Jo-yongju/ethernet-rs422-gateway/tests/테스트방법.md

Protocol V1 / Remote Node Unit Test

Folder structure

ethernet_rs422_gateway_protocol/
├─ common/
│  ├─ crc16.h
│  ├─ crc16.c
│  ├─ protocol.h
│  ├─ protocol.c
│  ├─ stream_parser.h
│  └─ stream_parser.c
├─ tests/
│  ├─ protocol_test.c
│  └─ stream_parser_test.c
└─ firmware/f429_remote_node/
   ├─ App/
   ├─ Common/
   └─ Tests/remote_node_test.c

Windows / MinGW GCC

From the project root:

gcc common\crc16.c common\protocol.c tests\protocol_test.c -Icommon -std=c11 -Wall -Wextra -Wpedantic -o protocol_test.exe
.\protocol_test.exe

gcc common\crc16.c common\protocol.c common\stream_parser.c tests\stream_parser_test.c -Icommon -std=c11 -Wall -Wextra -Wpedantic -o stream_parser_test.exe
.\stream_parser_test.exe

gcc firmware\f429_remote_node\Common\crc16.c firmware\f429_remote_node\Common\protocol.c firmware\f429_remote_node\Common\stream_parser.c firmware\f429_remote_node\App\Src\remote_node.c firmware\f429_remote_node\App\Src\uart_rx_ring.c firmware\f429_remote_node\Tests\remote_node_test.c -Ifirmware\f429_remote_node\Common -Ifirmware\f429_remote_node\App\Inc -std=c11 -Wall -Wextra -Wpedantic -o remote_node_test.exe
.\remote_node_test.exe

WSL / Linux GCC

gcc common/crc16.c common/protocol.c tests/protocol_test.c \
  -Icommon -std=c11 -Wall -Wextra -Wpedantic \
  -o protocol_test

./protocol_test

gcc common/crc16.c common/protocol.c common/stream_parser.c tests/stream_parser_test.c \
  -Icommon -std=c11 -Wall -Wextra -Wpedantic \
  -o stream_parser_test

./stream_parser_test

gcc firmware/f429_remote_node/Common/crc16.c \
  firmware/f429_remote_node/Common/protocol.c \
  firmware/f429_remote_node/Common/stream_parser.c \
  firmware/f429_remote_node/App/Src/remote_node.c \
  firmware/f429_remote_node/App/Src/uart_rx_ring.c \
  firmware/f429_remote_node/Tests/remote_node_test.c \
  -Ifirmware/f429_remote_node/Common \
  -Ifirmware/f429_remote_node/App/Inc \
  -std=c11 -Wall -Wextra -Wpedantic \
  -o remote_node_test

./remote_node_test

Expected result:

Protocol: 9 passed, 0 failed
Stream Parser: 8 passed, 0 failed
Remote Node: 13 passed, 0 failed
Total: 30 passed, 0 failed

Later in STM32CubeIDE

The reusable files are:

crc16.h
crc16.c
protocol.h
protocol.c
stream_parser.h
stream_parser.c

The files under tests/ and firmware/f429_remote_node/Tests/ are only for PC-side unit tests.

Do not put HAL calls inside the reusable protocol modules.
HAL/UART/SPI/Ethernet code will call these modules from the STM32 application layer.
