Jo-yongju/ethernet-rs422-gateway/results/day10/tcp_rtt_20000_1ms.csv

seq | rtt_ms | status
1 | 3.877100 | OK
2 | 4.412800 | OK
3 | 4.012900 | OK
4 | 4.248000 | OK
5 | 4.366900 | OK
6 | 4.008300 | OK
7 | 3.910300 | OK
8 | 4.675800 | OK
9 | 4.656300 | OK
10 | 4.949200 | OK
11 | 4.296000 | OK
12 | 4.325600 | OK
13 | 4.512600 | OK
14 | 4.680800 | OK
15 | 4.408100 | OK
16 | 5.667400 | OK
17 | 4.586800 | OK
18 | 4.884100 | OK
19 | 4.713700 | OK
20 | 4.675900 | OK
21 | 4.700800 | OK
22 | 4.473300 | OK
23 | 4.676500 | OK
24 | 4.855000 | OK
25 | 4.873700 | OK
26 | 4.847500 | OK
27 | 4.913600 | OK
28 | 4.078600 | OK
29 | 4.888100 | OK
30 | 4.906600 | OK
31 | 4.982600 | OK
32 | 4.757000 | OK
33 | 4.497900 | OK
34 | 4.052300 | OK
35 | 5.812200 | OK
36 | 4.570400 | OK
37 | 4.691700 | OK
38 | 4.837900 | OK
39 | 4.196400 | OK
40 | 4.708900 | OK
41 | 4.631200 | OK
42 | 4.763900 | OK
43 | 4.895100 | OK
44 | 5.554300 | OK
45 | 4.965600 | OK
46 | 4.465400 | OK
47 | 4.410500 | OK
48 | 4.646500 | OK
49 | 5.247800 | OK
50 | 4.996400 | OK
51 | 4.695100 | OK
52 | 4.723000 | OK
53 | 4.950500 | OK
54 | 4.771800 | OK
55 | 6.698400 | OK
56 | 4.682600 | OK
57 | 4.597200 | OK
58 | 4.878400 | OK
59 | 4.690400 | OK
60 | 5.025000 | OK
61 | 5.076200 | OK
62 | 4.665900 | OK
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
