Jo-yongju/ethernet-rs422-gateway/firmware/f429_remote_node/f429_remote_node.ioc

Mcu.UserName=STM32F429ZITx
PA0/WKUP.GPIO_Label=B1 [Blue PushButton]
PA0/WKUP.Signal=GPXTI0
PA1.GPIO_Label=MEMS_INT1 [L3GD20_INT1]
PA1.Signal=GPXTI1
PA10.GPIO_Label=STLINK_TX [STM32F103CBT6_PA2]
PA10.Signal=USART1_RX
PA11.GPIO_Label=R4
PA11.Signal=LTDC_R4
PA12.GPIO_Label=R5
PA12.Signal=LTDC_R5
PA13.GPIO_Label=SWDIO
PA13.Signal=SYS_JTMS-SWDIO
PA14.GPIO_Label=SWCLK
PA14.Signal=SYS_JTCK-SWCLK
PA15.GPIO_Label=TP_INT1 [Touch Panel]
PA15.Signal=GPXTI15
PA2.GPIO_Label=MEMS_INT2 [L3GD20_INT2]
PA2.Signal=GPXTI2
PA3.GPIO_Label=B5
PA3.Signal=LTDC_B5
PA4.GPIO_Label=VSYNC
PA4.Signal=LTDC_VSYNC
PA6.GPIO_Label=G2
PA6.Signal=LTDC_G2
PA7.GPIO_Label=ACP_RST
PA7.Signal=GPIO_Output
PA8.GPIO_Label=I2C3_SCL [ACP/RF_SCL]
PA8.Signal=I2C3_SCL
PA9.GPIO_Label=STLINK_RX [STM32F103CBT6_PA3]
PA9.Signal=USART1_TX
PB0.GPIO_Label=R3
PB0.Signal=LTDC_R3
PB1.GPIO_Label=R6
PB1.Signal=LTDC_R6
PB10.GPIO_Label=G4
PB10.Signal=LTDC_G4
PB11.GPIO_Label=G5
PB11.Signal=LTDC_G5
PB12.GPIO_Label=OTG_HS_ID
PB12.Signal=USB_OTG_HS_ID
PB13.GPIO_Label=VBUS_HS
PB13.Signal=USB_OTG_HS_VBUS
PB14.GPIO_Label=OTG_HS_DM
PB14.Signal=USB_OTG_HS_DM
PB15.GPIO_Label=OTG_HS_DP
PB15.Signal=USB_OTG_HS_DP
PB2/BOOT1.GPIO_Label=BOOT1
PB2/BOOT1.Signal=GPIO_Input
PB5.GPIO_Label=SDCKE1
PB5.Signal=FMC_SDCKE1
PB6.GPIO_Label=SDNE1 [SDRAM_CS]
PB6.Signal=FMC_SDNE1
PB8.GPIO_Label=B6
PB8.Signal=LTDC_B6
PB9.GPIO_Label=B7
PB9.Signal=LTDC_B7
PC0.GPIO_Label=SDNWE
PC0.Signal=FMC_SDNWE
PC1.GPIO_Label=NCS_MEMS_SPI [L3GD20_CS_I2C/SPI]
PC1.Signal=GPIO_Output
PC10.GPIO_Label=R2
PC10.Signal=LTDC_R2
PC12.Signal=UART5_TX
PC14/OSC32_IN.GPIO_Label=PC14-OSC32_IN
PC14/OSC32_IN.Signal=RCC_OSC32_IN
PC15/OSC32_OUT.GPIO_Label=PC15-OSC32_OUT
PC15/OSC32_OUT.Signal=RCC_OSC32_OUT
PC2.GPIO_Label=CSX [LCD-RGB_CSX]
PC2.Signal=GPIO_Output
PC4.GPIO_Label=OTG_FS_PSO [OTG_FS_PowerSwitchOn]
PC4.Signal=GPIO_Output
PC5.GPIO_Label=OTG_FS_OC [OTG_FS_OverCurrent]
PC5.Signal=GPXTI5
PC6.GPIO_Label=HSYNC
PC6.Signal=LTDC_HSYNC
PC7.GPIO_Label=G6
PC7.Signal=LTDC_G6
PC9.GPIO_Label=I2C3_SDA [ACP/RF_SDA]
PC9.Signal=I2C3_SDA
PD0.GPIO_Label=D2
PD0.Signal=FMC_D2_DA2
PD1.GPIO_Label=D3
PD1.Signal=FMC_D3_DA3
PD10.GPIO_Label=D15
PD10.Signal=FMC_D15_DA15
PD11.GPIO_Label=TE [LCD-RGB_TE]
PD11.Signal=GPIO_Input
PD12.GPIO_Label=RDX [LDC-RGB_RDX]
PD12.Signal=GPIO_Output
PD13.GPIO_Label=WRX_DCX [LCD-RGB_WRX_DCX]
PD13.Signal=GPIO_Output
PD14.GPIO_Label=D0
PD14.Signal=FMC_D0_DA0
PD15.GPIO_Label=D1
PD15.Signal=FMC_D1_DA1
PD2.Signal=UART5_RX
PD3.GPIO_Label=G7
PD3.Signal=LTDC_G7
PD6.GPIO_Label=B2
PD6.Signal=LTDC_B2
PD8.GPIO_Label=D13
PD8.Signal=FMC_D13_DA13
PD9.GPIO_Label=D14
PD9.Signal=FMC_D14_DA14
PE0.GPIO_Label=NBL0 [SDRAM_LDQM]
PE0.Signal=FMC_NBL0
PE1.GPIO_Label=NBL1 [SDRAM_UDQM]
PE1.Signal=FMC_NBL1
PE10.GPIO_Label=D7
PE10.Signal=FMC_D7_DA7
PE11.GPIO_Label=D8
PE11.Signal=FMC_D8_DA8
PE12.GPIO_Label=D9
PE12.Signal=FMC_D9_DA9
PE13.GPIO_Label=D10
PE13.Signal=FMC_D10_DA10
PE14.GPIO_Label=D11
PE14.Signal=FMC_D11_DA11
PE15.GPIO_Label=D12
PE15.Signal=FMC_D12_DA12
PE7.GPIO_Label=D4
PE7.Signal=FMC_D4_DA4
PE8.GPIO_Label=D5
PE8.Signal=FMC_D5_DA5
PE9.GPIO_Label=D6
PE9.Signal=FMC_D6_DA6
PF0.GPIO_Label=A0
PF0.Signal=FMC_A0
PF1.GPIO_Label=A1
PF1.Signal=FMC_A1
PF10.GPIO_Label=ENABLE [LCD-RGB_ENABLE]
PF10.Signal=LTDC_DE
PF11.GPIO_Label=SDNRAS
PF11.Signal=FMC_SDNRAS
PF12.GPIO_Label=A6
PF12.Signal=FMC_A6
PF13.GPIO_Label=A7
PF13.Signal=FMC_A7
PF14.GPIO_Label=A8
PF14.Signal=FMC_A8
PF15.GPIO_Label=A9
PF15.Signal=FMC_A9
PF2.GPIO_Label=A2
PF2.Signal=FMC_A2
PF3.GPIO_Label=A3
PF3.Signal=FMC_A3
PF4.GPIO_Label=A4
PF4.Signal=FMC_A4
PF5.GPIO_Label=A5
PF5.Signal=FMC_A5
PF7.GPIO_Label=SPI5_SCK [L3GD20_SCL/SPC]
PF7.Signal=SPI5_SCK
PF8.GPIO_Label=SPI5_MISO [L3GD20_SDO]
PF8.Signal=SPI5_MISO
PF9.GPIO_Label=SPI5_MOSI [L3GD20_SDA/SDI/SDO]
PF9.Signal=SPI5_MOSI
PG0.GPIO_Label=A10
PG0.Signal=FMC_A10
PG1.GPIO_Label=A11
PG1.Signal=FMC_A11
PG10.GPIO_Label=G3
PG10.Signal=LTDC_G3
PG11.GPIO_Label=B3
PG11.Signal=LTDC_B3
PG12.GPIO_Label=B4
PG12.Signal=LTDC_B4
PG13.GPIO_Label=LD3 [Green Led]
PG13.Signal=GPIO_Output
PG14.GPIO_Label=LD4 [Red Led]
PG14.Signal=GPIO_Output
PG15.GPIO_Label=SDNCAS
PG15.Signal=FMC_SDNCAS
PG4.GPIO_Label=BA0
PG4.Signal=FMC_A14_BA0
PG5.GPIO_Label=BA1
PG5.Signal=FMC_A15_BA1
PG6.GPIO_Label=R7
PG6.Signal=LTDC_R7
PG7.GPIO_Label=DOTCLK [LCT-RGB_DOTCLK]
PG7.Signal=LTDC_CLK
PG8.GPIO_Label=SDCLK
PG8.Signal=FMC_SDCLK
PH0/OSC_IN.GPIO_Label=PH0-OSC_IN
PH0/OSC_IN.Signal=RCC_OSC_IN
PH1/OSC_OUT.GPIO_Label=PH1-OSC_OUT
PH1/OSC_OUT.Signal=RCC_OSC_OUT
