Jo-yongju/ethernet-rs422-gateway/firmware/f429_remote_node/App/Inc/remote_node_port.h

#ifndef REMOTE_NODE_PORT_H
#define REMOTE_NODE_PORT_H

#ifdef __cplusplus
extern "C" {
#endif

int remote_node_port_init(void);
void remote_node_port_process(void);

#ifdef __cplusplus
}
#endif

#endif /* REMOTE_NODE_PORT_H */
