Jo-yongju/ethernet-rs422-gateway/(commit log)

2026-08-31 feat: add W5500 SPI bring-up and PHY link monitoring
2026-09-07 feat(gateway): add ethernet fault recovery
    - recover W5500 TCP server after Ethernet link flap
    - handle TCP socket lifecycle and stale connection context
    - separate boot/lifecycle events from Ethernet fault counters
    - add host CRC fault injection client
    - preserve existing RS-422 and UDP routing behavior
2026-09-08 feat(gateway): finalize validation and recovery tests
    [day10_step1_tcp_baseline.csv, day10_step1_udp_baseline.csv, day10_step2_tcp_run1.csv, day10_step2_tcp_run2.csv, day10_step2_tcp_run3.csv, day10_step3_udp_1000.csv, day10_step4_concurrent_tcp_run1.csv, day10_step4_concurrent_tcp_run2.csv]
2026-09-12 docs: add 20k TCP RTT endurance results
    [tcp_rtt_20000_1ms.csv]
2026-09-13 chore: align supported toolchain files
    Align the F429 Remote Node project files with the configured STM32CubeIDE workflow.
